tannewt/p4gpio/p4gpio.kicad_pcb

## KiCad design p4gpio.kicad_pcb (2026-05-11)

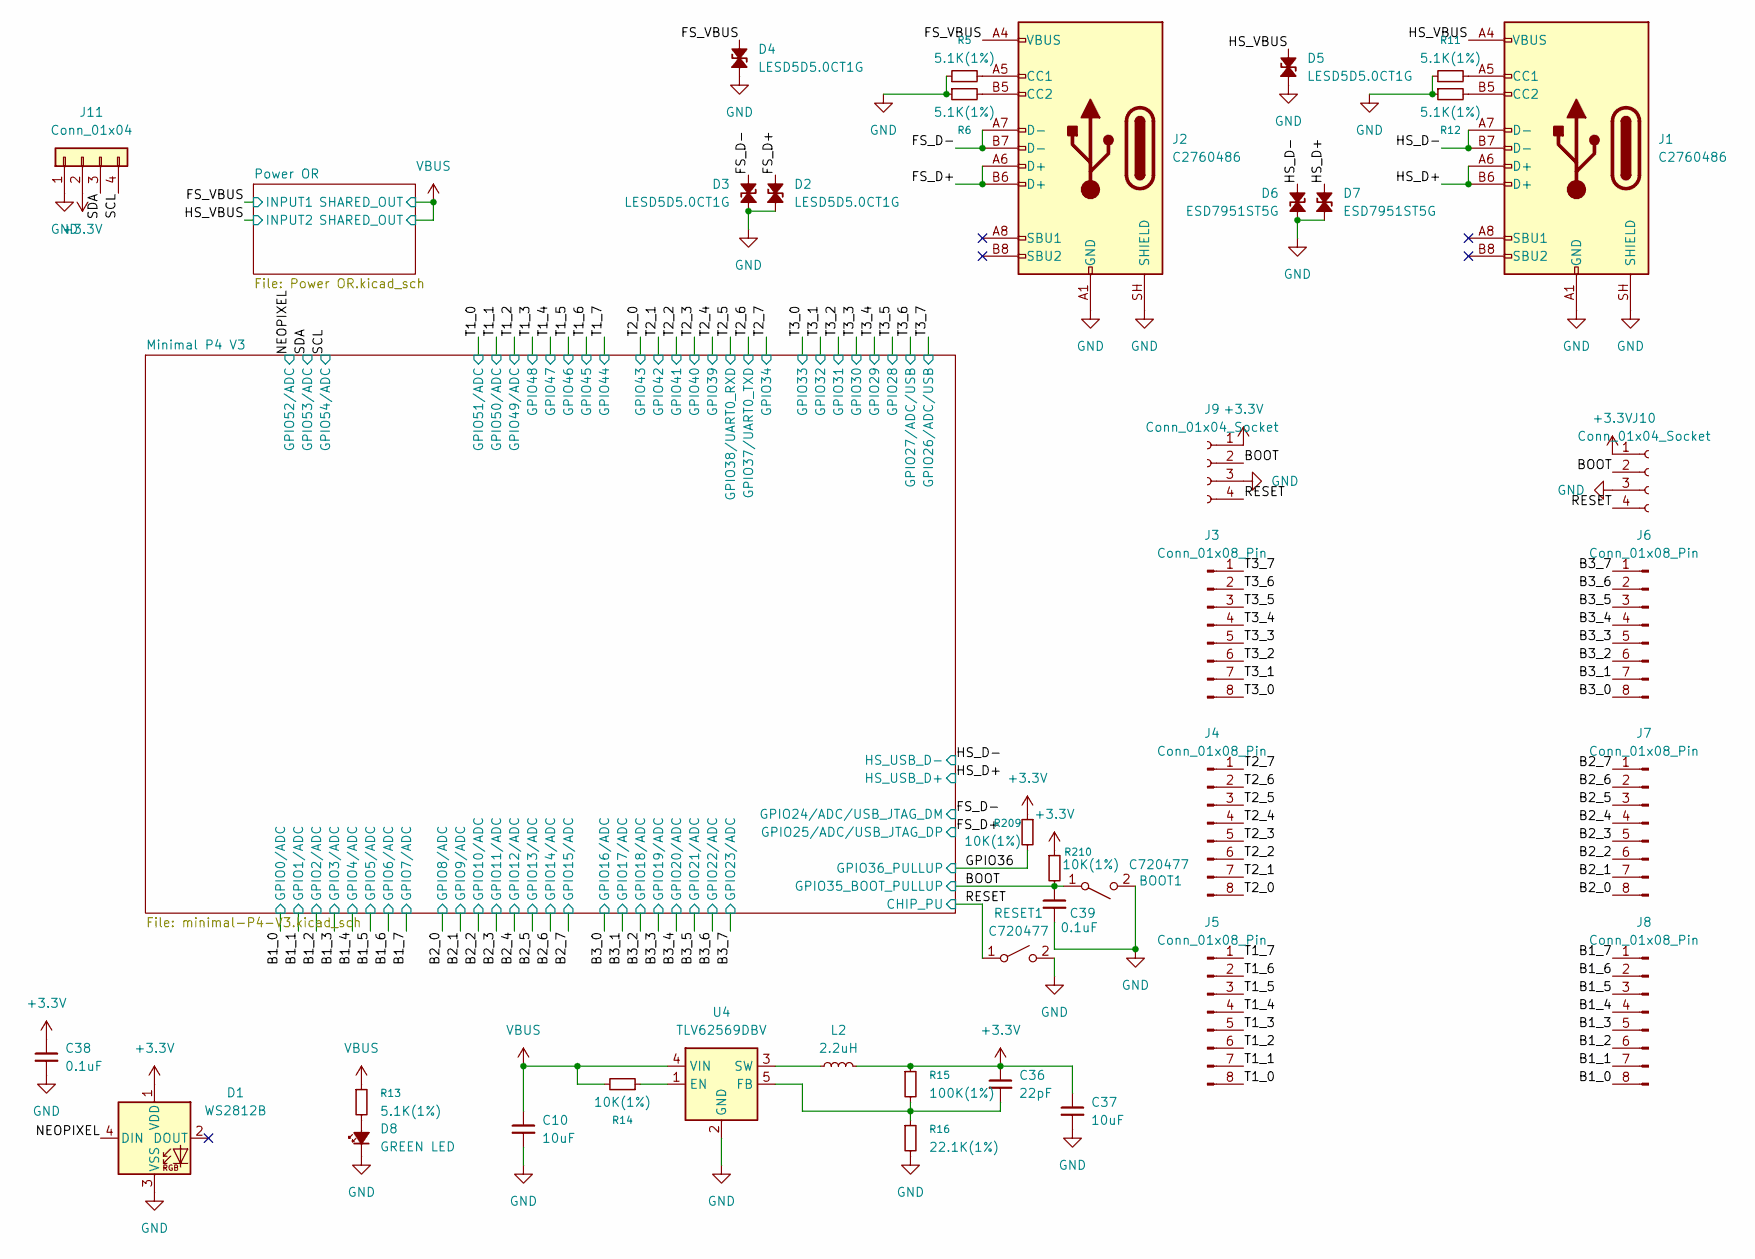
[picture p1: schematic p4gpio.kicad_sch]

Parts:
BOOT1: C720477; SW_SPST_TS-1088-xR020
C10, C37: 10uF; C_0603_1608Metric
C36: 22pF; C_0402_1005Metric
C38, C39: 0.1uF; C_0402_1005Metric
D1: WS2812B; LED_WS2812B_PLCC4_5.0x5.0mm_P3.2mm
D2, D3, D4, D5: LESD5D5.0CT1G; D_SOD-523
D6, D7: ESD7951ST5G; D_SOD-882
D8: GREEN LED; D_0805_2012Metric
J1, J2: C2760486; USB_C_Receptacle_HRO_TYPE-C-31-M-31
J3, J4, J5, J6, J7, J8: Conn_01x08_Pin; PinHeader_1x08_P2.54mm_Vertical
J9, J10: Conn_01x04_Socket; PinSocket_1x04_P2.54mm_Vertical
J11: Conn_01x04; JST_SH_SM04B-SRSS-TB_1x04-1MP_P1.00mm_Horizontal
L2: 2.2uH; L_1008_2520Metric
R5, R6, R11, R12, R13: 5.1K(1%); R_0402_1005Metric
R14, R209, R210: 10K(1%); R_0402_1005Metric
R15: 100K(1%); R_0402_1005Metric
R16: 22.1K(1%); R_0402_1005Metric
RESET1: C720477; SW_SPST_TS-1088-xR020
U4: TLV62569DBV; SOT-23-5

Connections:
+3.3V: C36.1, C37.1, C38.1, D1.1 (VDD), J9.1, J10.1, J11.2, L2.2, R15.1, R209.1, R210.1; also elsewhere on the board
/B1_0: J8.8; also elsewhere on the board
/B1_1: J8.7; also elsewhere on the board
/B1_2: J8.6; also elsewhere on the board
/B1_3: J8.5; also elsewhere on the board
/B1_4: J8.4; also elsewhere on the board
/B1_5: J8.3; also elsewhere on the board
/B1_6: J8.2; also elsewhere on the board
/B1_7: J8.1; also elsewhere on the board
/B2_0: J7.8; also elsewhere on the board
/B2_1: J7.7; also elsewhere on the board
/B2_2: J7.6; also elsewhere on the board
/B2_3: J7.5; also elsewhere on the board
/B2_4: J7.4; also elsewhere on the board
/B2_5: J7.3; also elsewhere on the board
/B2_6: J7.2; also elsewhere on the board
/B2_7: J7.1; also elsewhere on the board
/B3_0: J6.8; also elsewhere on the board
/B3_1: J6.7; also elsewhere on the board
/B3_2: J6.6; also elsewhere on the board
/B3_3: J6.5; also elsewhere on the board
/B3_4: J6.4; also elsewhere on the board
/B3_5: J6.3; also elsewhere on the board
/B3_6: J6.2; also elsewhere on the board
/B3_7: J6.1; also elsewhere on the board
/BOOT: BOOT1.1 (A), C39.1, J9.2, J10.2, R210.2; also elsewhere on the board
/FS_D+: D2.2 (A2), J2.A6 (D+), J2.B6 (D+); also elsewhere on the board
/FS_D-: D3.2 (A2), J2.A7 (D-), J2.B7 (D-); also elsewhere on the board
/FS_VBUS: D4.2 (A2), J2.A4 (VBUS), J2.A9 (VBUS), J2.B4 (VBUS), J2.B9 (VBUS); also elsewhere on the board
/GPIO36: R209.2; also elsewhere on the board
/HS_D+: D7.2 (A2), J1.A6 (D+), J1.B6 (D+); also elsewhere on the board
/HS_D-: D6.2 (A2), J1.A7 (D-), J1.B7 (D-); also elsewhere on the board
/HS_VBUS: D5.2 (A2), J1.A4 (VBUS), J1.A9 (VBUS), J1.B4 (VBUS), J1.B9 (VBUS); also elsewhere on the board
/NEOPIXEL: D1.4 (DIN); also elsewhere on the board
/RESET: J9.4, J10.4, RESET1.1 (A); also elsewhere on the board
/SCL: J11.4; also elsewhere on the board
/SDA: J11.3; also elsewhere on the board
/T1_0: J5.8; also elsewhere on the board
/T1_1: J5.7; also elsewhere on the board
/T1_2: J5.6; also elsewhere on the board
/T1_3: J5.5; also elsewhere on the board
/T1_4: J5.4; also elsewhere on the board
/T1_5: J5.3; also elsewhere on the board
/T1_6: J5.2; also elsewhere on the board
/T1_7: J5.1; also elsewhere on the board
/T2_0: J4.8; also elsewhere on the board
/T2_1: J4.7; also elsewhere on the board
/T2_2: J4.6; also elsewhere on the board
/T2_3: J4.5; also elsewhere on the board
/T2_4: J4.4; also elsewhere on the board
/T2_5: J4.3; also elsewhere on the board
/T2_6: J4.2; also elsewhere on the board
/T2_7: J4.1; also elsewhere on the board
/T3_0: J3.8; also elsewhere on the board
/T3_1: J3.7; also elsewhere on the board
/T3_2: J3.6; also elsewhere on the board
/T3_3: J3.5; also elsewhere on the board
/T3_4: J3.4; also elsewhere on the board
/T3_5: J3.3; also elsewhere on the board
/T3_6: J3.2; also elsewhere on the board
/T3_7: J3.1; also elsewhere on the board
GND: BOOT1.2 (B), C10.2, C37.2, C38.2, C39.2, D1.3 (VSS), D2.1 (A1), D3.1 (A1), D4.1 (A1), D5.1 (A1), D6.1 (A1), D7.1 (A1), D8.1 (K), J1.A1 (GND), J1.A12 (GND), J1.B1 (GND), J1.B12 (GND), J1.SH (SHIELD), J2.A1 (GND), J2.A12 (GND), J2.B1 (GND), J2.B12 (GND), J2.SH (SHIELD), J9.3, J10.3, J11.1, R5.1, R6.1, R11.1, R12.1, R16.2, RESET1.2 (B), U4.2 (GND); also elsewhere on the board
unnamed: D8.2 (A), R13.2
unnamed: J1.A5 (CC1), R11.2
unnamed: J1.B5 (CC2), R12.2
unnamed: J2.A5 (CC1), R5.2
unnamed: J2.B5 (CC2), R6.2
unnamed: R14.1, U4.1 (EN)
unnamed: C36.2, R15.2, R16.1, U4.5 (FB)
unnamed: L2.1, U4.3 (SW)
VBUS: C10.1, R13.1, R14.2, U4.4 (VIN); also elsewhere on the board

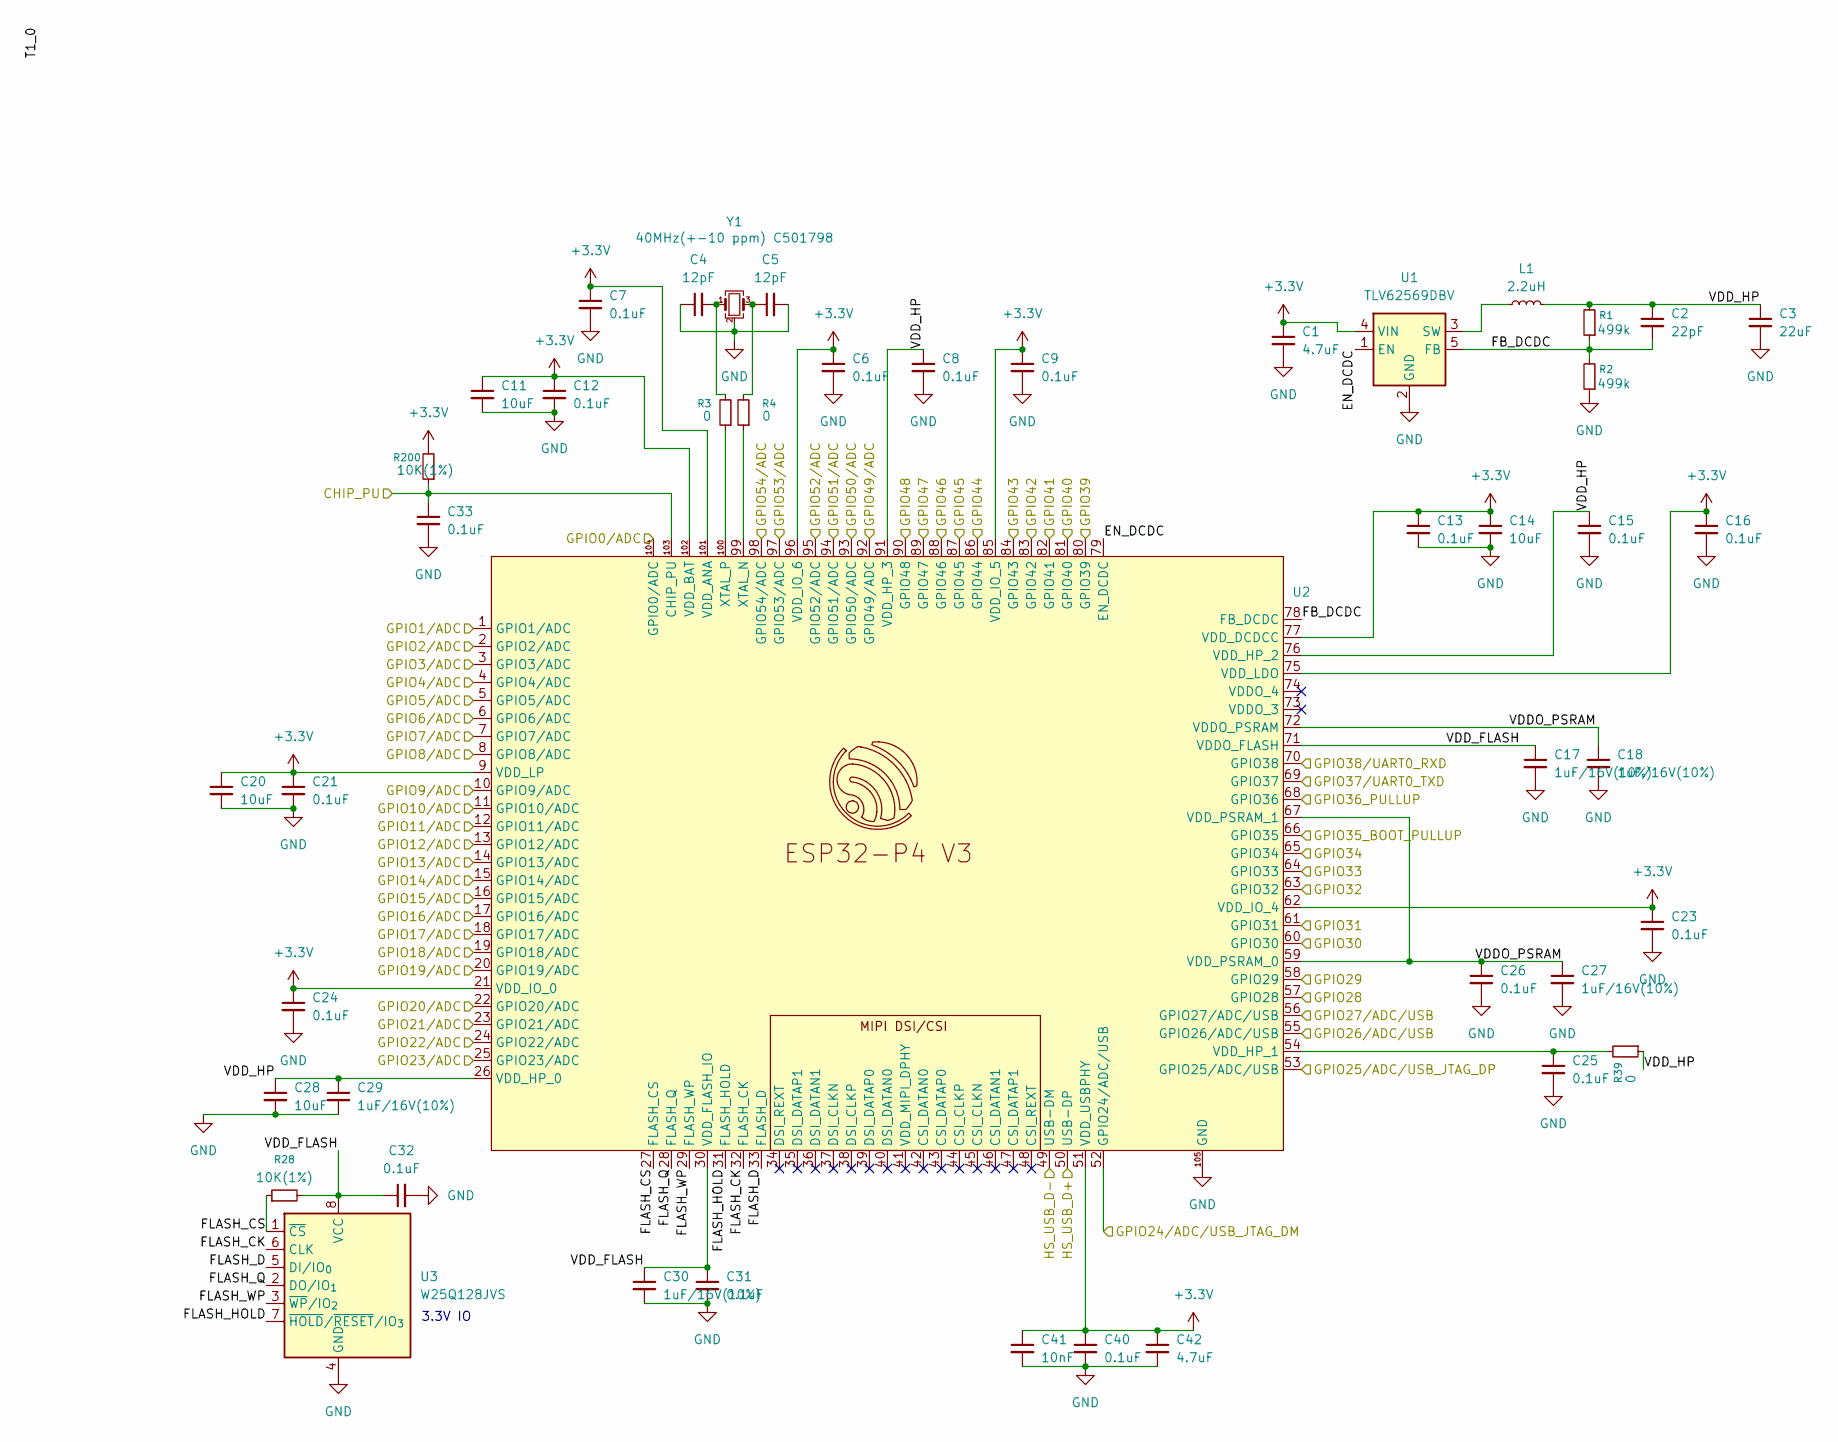
[picture p2: schematic minimal-P4-V3.kicad_sch]

Parts:
C1, C42: 4.7uF; C_0402_1005Metric
C2: 22pF; C_0402_1005Metric
C3: 22uF; C_0603_1608Metric
C4, C5: 12pF; C_0402_1005Metric
C6, C7, C8, C9, C12, C13, C15, C16, C21, C23, C24, C25, C26, C31, C32, C33, C40: 0.1uF; C_0402_1005Metric
C11, C14, C20, C28: 10uF; C_0603_1608Metric
C17, C18, C27, C29, C30: 1uF/16V(10%); C_0402_1005Metric
C41: 10nF; C_0402_1005Metric
L1: 2.2uH; L_1008_2520Metric
R1, R2: 499k; R_0402_1005Metric
R3, R4, R39: 0; R_0402_1005Metric
R28, R200: 10K(1%); R_0402_1005Metric
U1: TLV62569DBV; SOT-23-5
U2: ESP32-P4
U3: W25Q128JVS; WSON-8-1EP_6x5mm_P1.27mm_EP3.4x4.3mm
Y1: 40MHz(+-10 ppm) C501798; Crystal_SMD_2016-4Pin_2.0x1.6mm

Connections:
+3.3V: C1.1, C6.1, C7.1, C9.1, C11.1, C12.1, C13.1, C14.1, C16.1, C20.1, C21.1, C23.1, C24.1, C40.1, C41.1, C42.1, R200.2, U1.4 (VIN), U2.9 (VDD_LP), U2.21 (VDD_IO_0), U2.51 (VDD_USBPHY), U2.62 (VDD_IO_4), U2.75 (VDD_LDO), U2.77 (VDD_DCDCC), U2.85 (VDD_IO_5), U2.96 (VDD_IO_6), U2.101 (VDD_ANA), U2.102 (VDD_BAT); also elsewhere on the board
/B1_0: U2.104 (GPIO0/ADC); also elsewhere on the board
/B1_1: U2.1 (GPIO1/ADC); also elsewhere on the board
/B1_2: U2.2 (GPIO2/ADC); also elsewhere on the board
/B1_3: U2.3 (GPIO3/ADC); also elsewhere on the board
/B1_4: U2.4 (GPIO4/ADC); also elsewhere on the board
/B1_5: U2.5 (GPIO5/ADC); also elsewhere on the board
/B1_6: U2.6 (GPIO6/ADC); also elsewhere on the board
/B1_7: U2.7 (GPIO7/ADC); also elsewhere on the board
/B2_0: U2.8 (GPIO8/ADC); also elsewhere on the board
/B2_1: U2.10 (GPIO9/ADC); also elsewhere on the board
/B2_2: U2.11 (GPIO10/ADC); also elsewhere on the board
/B2_3: U2.12 (GPIO11/ADC); also elsewhere on the board
/B2_4: U2.13 (GPIO12/ADC); also elsewhere on the board
/B2_5: U2.14 (GPIO13/ADC); also elsewhere on the board
/B2_6: U2.15 (GPIO14/ADC); also elsewhere on the board
/B2_7: U2.16 (GPIO15/ADC); also elsewhere on the board
/B3_0: U2.17 (GPIO16/ADC); also elsewhere on the board
/B3_1: U2.18 (GPIO17/ADC); also elsewhere on the board
/B3_2: U2.19 (GPIO18/ADC); also elsewhere on the board
/B3_3: U2.20 (GPIO19/ADC); also elsewhere on the board
/B3_4: U2.22 (GPIO20/ADC); also elsewhere on the board
/B3_5: U2.23 (GPIO21/ADC); also elsewhere on the board
/B3_6: U2.24 (GPIO22/ADC); also elsewhere on the board
/B3_7: U2.25 (GPIO23/ADC); also elsewhere on the board
/BOOT: U2.66 (GPIO35); also elsewhere on the board
/FS_D+: U2.53 (GPIO25/ADC/USB); also elsewhere on the board
/FS_D-: U2.52 (GPIO24/ADC/USB); also elsewhere on the board
/GPIO36: U2.68 (GPIO36); also elsewhere on the board
/HS_D+: U2.50 (USB-DP); also elsewhere on the board
/HS_D-: U2.49 (USB-DM); also elsewhere on the board
/Minimal P4 V3/EN_DCDC: U1.1 (EN), U2.79 (EN_DCDC)
/Minimal P4 V3/FB_DCDC: C2.2, R1.1, R2.2, U1.5 (FB), U2.78 (FB_DCDC)
/Minimal P4 V3/FLASH_CK: U2.32 (FLASH_CK), U3.6 (CLK)
/Minimal P4 V3/FLASH_CS: R28.1, U2.27 (FLASH_CS), U3.1 (~CS)
/Minimal P4 V3/FLASH_D: U2.33 (FLASH_D), U3.5 (DI/IO_{0})
/Minimal P4 V3/FLASH_HOLD: U2.31 (FLASH_HOLD), U3.7 (~HOLD/~RESET/IO_{3})
/Minimal P4 V3/FLASH_Q: U2.28 (FLASH_Q), U3.2 (DO/IO_{1})
/Minimal P4 V3/FLASH_WP: U2.29 (FLASH_WP), U3.3 (~WP/IO_{2})
/Minimal P4 V3/VDDO_PSRAM: C18.1, C26.1, C27.1, U2.59 (VDD_PSRAM_0), U2.67 (VDD_PSRAM_1), U2.72 (VDDO_PSRAM)
/Minimal P4 V3/VDD_FLASH: C17.1, C30.1, C31.1, C32.1, R28.2, U2.30 (VDD_FLASH_IO), U2.71 (VDDO_FLASH), U3.8 (VCC)
/Minimal P4 V3/VDD_HP: C2.1, C3.1, C8.1, C15.1, C28.1, C29.1, L1.2, R1.2, R39.1, U2.26 (VDD_HP_0), U2.76 (VDD_HP_2), U2.91 (VDD_HP_3)
/NEOPIXEL: U2.95 (GPIO52/ADC); also elsewhere on the board
/RESET: C33.1, R200.1, U2.103 (CHIP_PU); also elsewhere on the board
/SCL: U2.98 (GPIO54/ADC); also elsewhere on the board
/SDA: U2.97 (GPIO53/ADC); also elsewhere on the board
/T1_0: U2.94 (GPIO51/ADC); also elsewhere on the board
/T1_1: U2.93 (GPIO50/ADC); also elsewhere on the board
/T1_2: U2.92 (GPIO49/ADC); also elsewhere on the board
/T1_3: U2.90 (GPIO48); also elsewhere on the board
/T1_4: U2.89 (GPIO47); also elsewhere on the board
/T1_5: U2.88 (GPIO46); also elsewhere on the board
/T1_6: U2.87 (GPIO45); also elsewhere on the board
/T1_7: U2.86 (GPIO44); also elsewhere on the board
/T2_0: U2.84 (GPIO43); also elsewhere on the board
/T2_1: U2.83 (GPIO42); also elsewhere on the board
/T2_2: U2.82 (GPIO41); also elsewhere on the board
/T2_3: U2.81 (GPIO40); also elsewhere on the board
/T2_4: U2.80 (GPIO39); also elsewhere on the board
/T2_5: U2.70 (GPIO38); also elsewhere on the board
/T2_6: U2.69 (GPIO37); also elsewhere on the board
/T2_7: U2.65 (GPIO34); also elsewhere on the board
/T3_0: U2.64 (GPIO33); also elsewhere on the board
/T3_1: U2.63 (GPIO32); also elsewhere on the board
/T3_2: U2.61 (GPIO31); also elsewhere on the board
/T3_3: U2.60 (GPIO30); also elsewhere on the board
/T3_4: U2.58 (GPIO29); also elsewhere on the board
/T3_5: U2.57 (GPIO28); also elsewhere on the board
/T3_6: U2.56 (GPIO27/ADC/USB); also elsewhere on the board
/T3_7: U2.55 (GPIO26/ADC/USB); also elsewhere on the board
GND: C1.2, C3.2, C4.1, C5.2, C6.2, C7.2, C8.2, C9.2, C11.2, C12.2, C13.2, C14.2, C15.2, C16.2, C17.2, C18.2, C20.2, C21.2, C23.2, C24.2, C25.2, C26.2, C27.2, C28.2, C29.2, C30.2, C31.2, C32.2, C33.2, C40.2, C41.2, C42.2, R2.1, U1.2 (GND), U2.105 (GND), U3.4 (GND), Y1.2 (G), Y1.4 (G); also elsewhere on the board
unnamed: C4.2, R3.2, Y1.1
unnamed: C5.1, R4.2, Y1.3
unnamed: L1.1, U1.3 (SW)
unnamed: C25.1, R39.2, U2.54 (VDD_HP_1)
unnamed: R4.1, U2.99 (XTAL_N)
unnamed: R3.1, U2.100 (XTAL_P)

Notes on the sheet:
3.3V IO

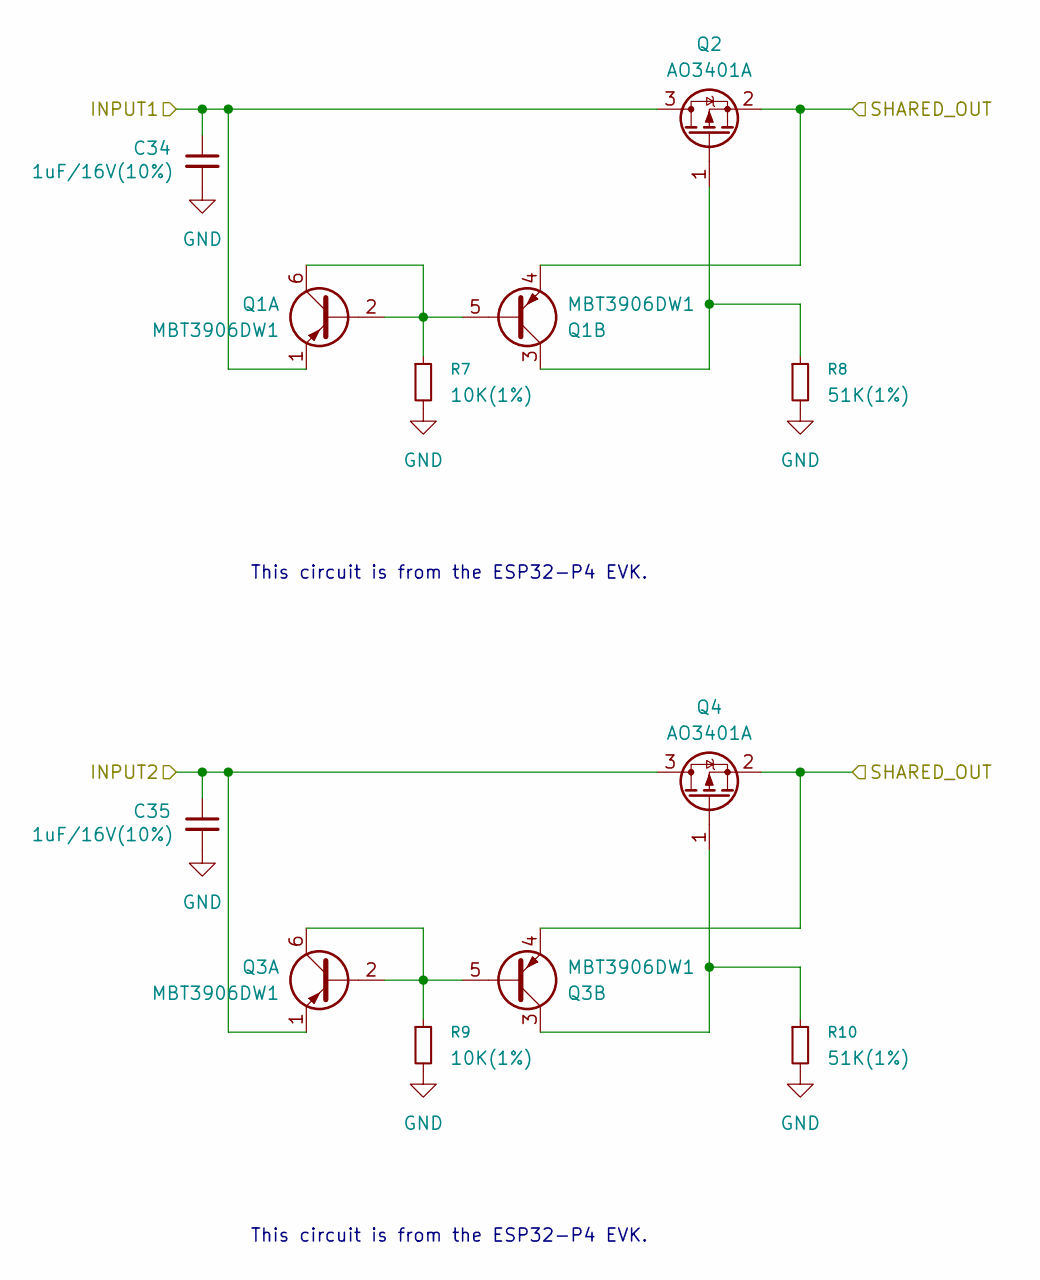
[picture p3: schematic Power OR.kicad_sch]

Parts:
C34, C35: 1uF/16V(10%); C_0402_1005Metric
Q1, Q3: MBT3906DW1; SOT-363_SC-70-6
Q2, Q4: AO3401A; SOT-23
R7, R9: 10K(1%); R_0402_1005Metric
R8, R10: 51K(1%); R_0402_1005Metric

Connections:
/FS_VBUS: C34.1, Q1.1 (E1), Q2.3 (D); also elsewhere on the board
/HS_VBUS: C35.1, Q3.1 (E1), Q4.3 (D); also elsewhere on the board
GND: C34.2, C35.2, R7.2, R8.2, R9.2, R10.2; also elsewhere on the board
unnamed: Q1.2 (B1), Q1.5 (B2), Q1.6 (C1), R7.1
unnamed: Q1.3 (C2), Q2.1 (G), R8.1
unnamed: Q3.2 (B1), Q3.5 (B2), Q3.6 (C1), R9.1
unnamed: Q3.3 (C2), Q4.1 (G), R10.1
VBUS: Q1.4 (E2), Q2.2 (S), Q3.4 (E2), Q4.2 (S); also elsewhere on the board

Notes on the sheet:
This circuit is from the ESP32-P4 EVK.

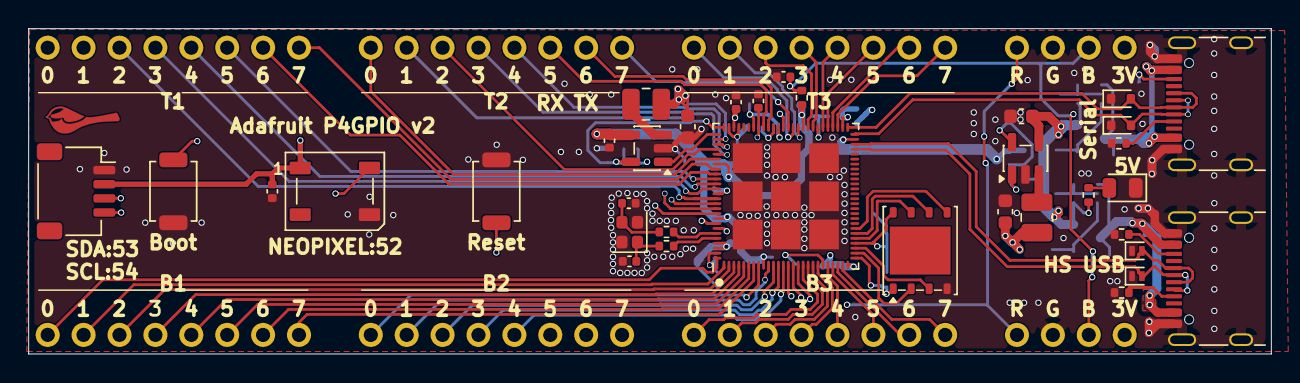
[picture p4: board p4gpio.kicad_pcb from above]

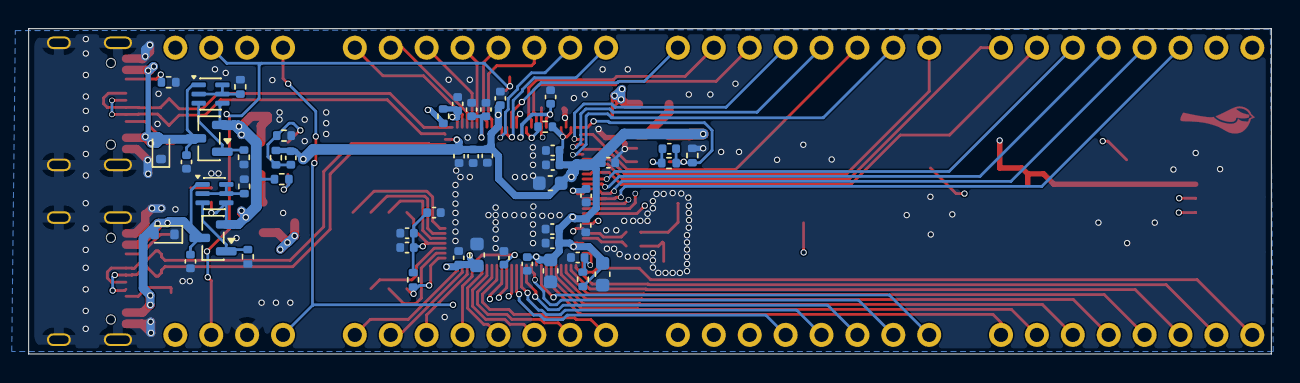
[picture p5: board p4gpio.kicad_pcb from below]

Board: 4 copper layers, 87.9 x 23.0 mm, 93 parts (56 on the bottom side), 92 nets.
