tannewt/p4gpio/(commit log)

2026-04-16 Initial version of minimal ESP32-P4 dev board
    (Core schematic done in preparation for design blockification)
    [minimal-P4-V3.kicad_sch, p4gpio.kicad_pcb, p4gpio.kicad_sch]
2026-04-18 Start work on layout
    [minimal-P4-V3.kicad_sch, p4gpio.kicad_pcb, p4gpio.kicad_sch]
2026-04-20 Schematic done except for GPIO
    [Ideal Diode.kicad_sch, Power OR.kicad_sch, p4gpio.kicad_pcb, p4gpio.kicad_sch]
2026-04-20 Setup design rules. Start to match up pins
    [minimal-P4-V3.kicad_sch, p4gpio.kicad_pcb, p4gpio.kicad_sch]
2026-04-21 Lots more routing and placement
    [Ideal Diode.kicad_sch, Power OR.kicad_sch, minimal-P4-V3.kicad_sch, p4gpio.kicad_pcb, p4gpio.kicad_sch]
2026-04-21 More power routing
    [minimal-P4-V3.kicad_sch, p4gpio.kicad_pcb]
2026-04-22 more routing
    [p4gpio.kicad_pcb]
2026-04-22 Fix bootstrapping pins. Start fixing DRC
    [minimal-P4-V3.kicad_sch, p4gpio.kicad_pcb, p4gpio.kicad_sch]
2026-04-23 Prep to order. Need to make vias bigger
    [p4gpio-CuBottom.gbr, p4gpio-CuIn1.gbr, p4gpio-CuIn2.gbr, p4gpio-CuTop.gbr, p4gpio-EdgeCuts.gbr, p4gpio-MaskBottom.gbr, p4gpio-MaskTop.gbr, p4gpio-NPTH.drl]
2026-05-07 Connect flash VDD and skooch USBs apart. Start of v2
    [minimal-P4-V3.kicad_sch, p4gpio.kicad_pcb, p4gpio.kicad_sch]
2026-05-07 ready for v2
    [minimal-P4-V3.kicad_sch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]
2026-05-11 Add bom and cpl
    [BOM-p4gpio.csv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]
